arshiaabazari/biphasic-FES-stimulator/Docs/Images/breadboard_prototype.jpg

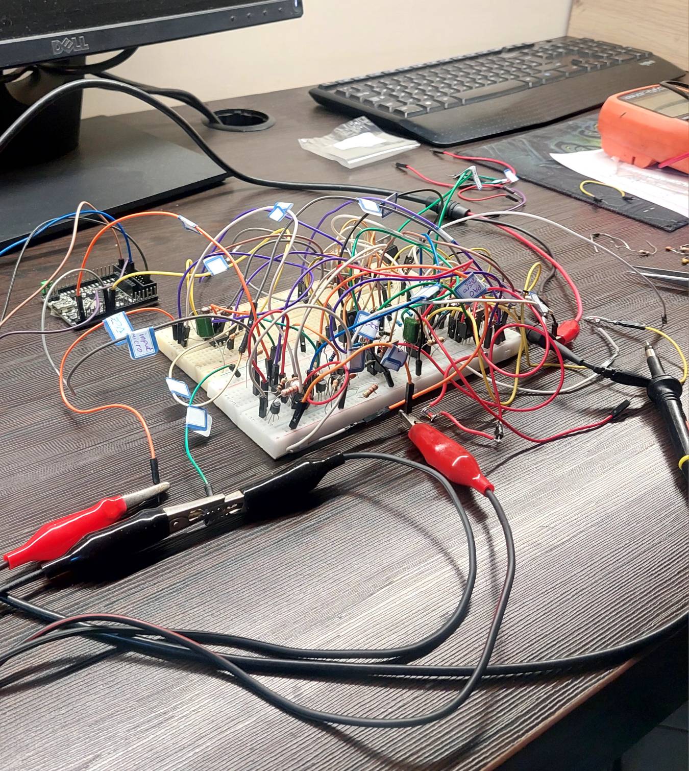
Docs/Images/breadboard_prototype.jpg
