arshiaabazari/biphasic-FES-stimulator/Docs/Images/final-hbridge_schematic-Proteus.png

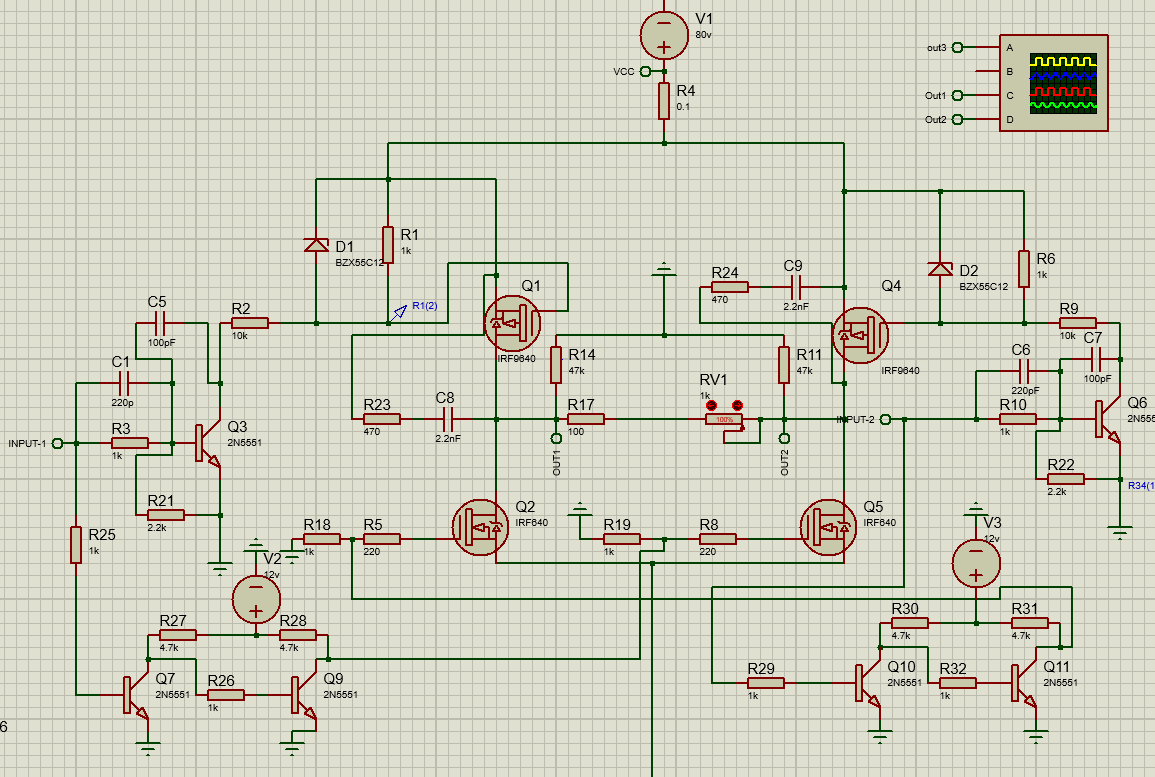
Docs/Images/final-hbridge_schematic-Proteus.png
