arshiaabazari/biphasic-FES-stimulator/Docs/Images/first-hbridge_schematic-Altium.jpg

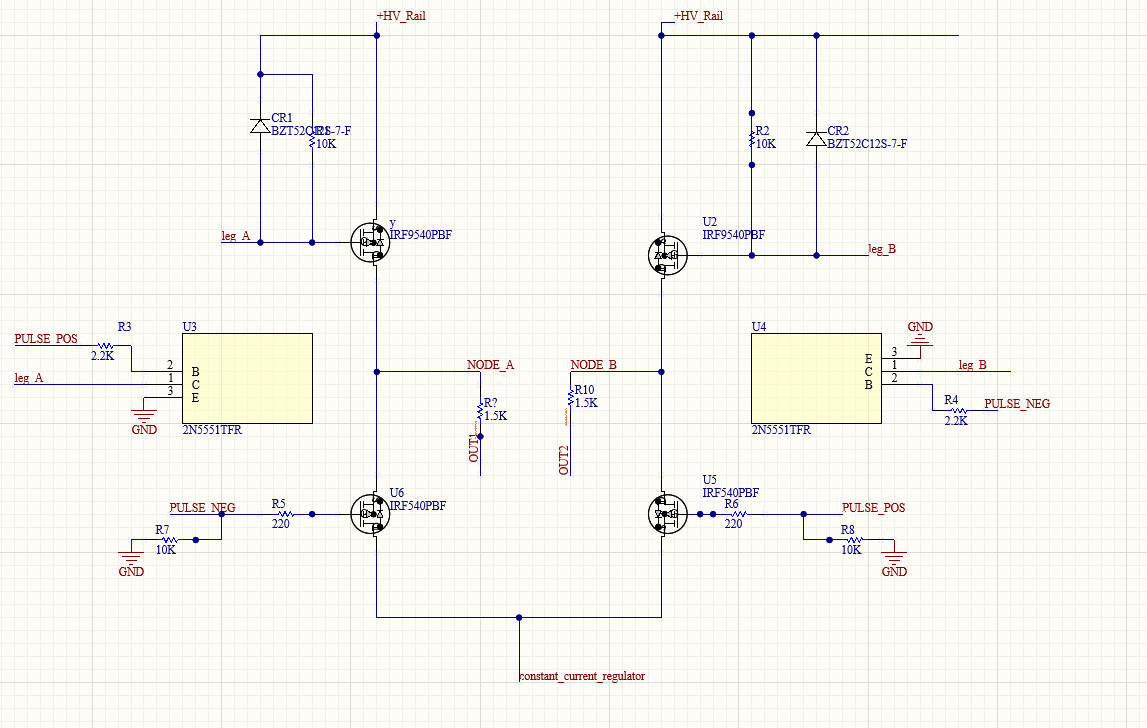
Docs/Images/first-hbridge_schematic-Altium.jpg
