arshiaabazari/biphasic-FES-stimulator/Docs/Images/oscilloscope_waveform-12V.jpg

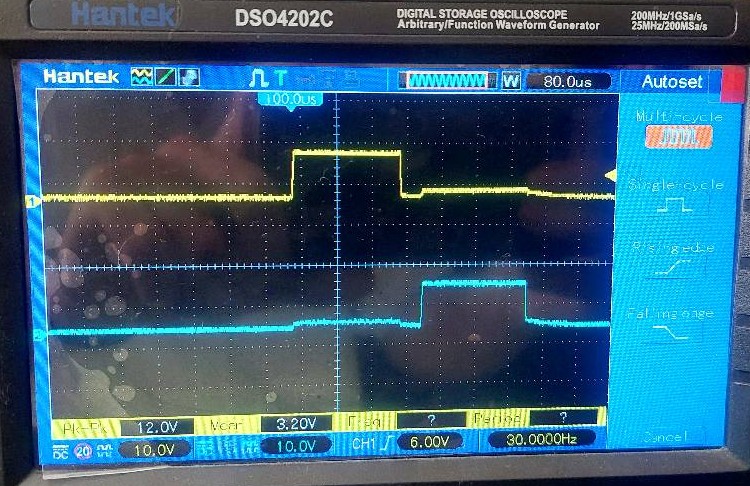
Docs/Images/oscilloscope_waveform-12V.jpg
