arshiaabazari/biphasic-FES-stimulator/Docs/Images/pulse_architecture.jpg

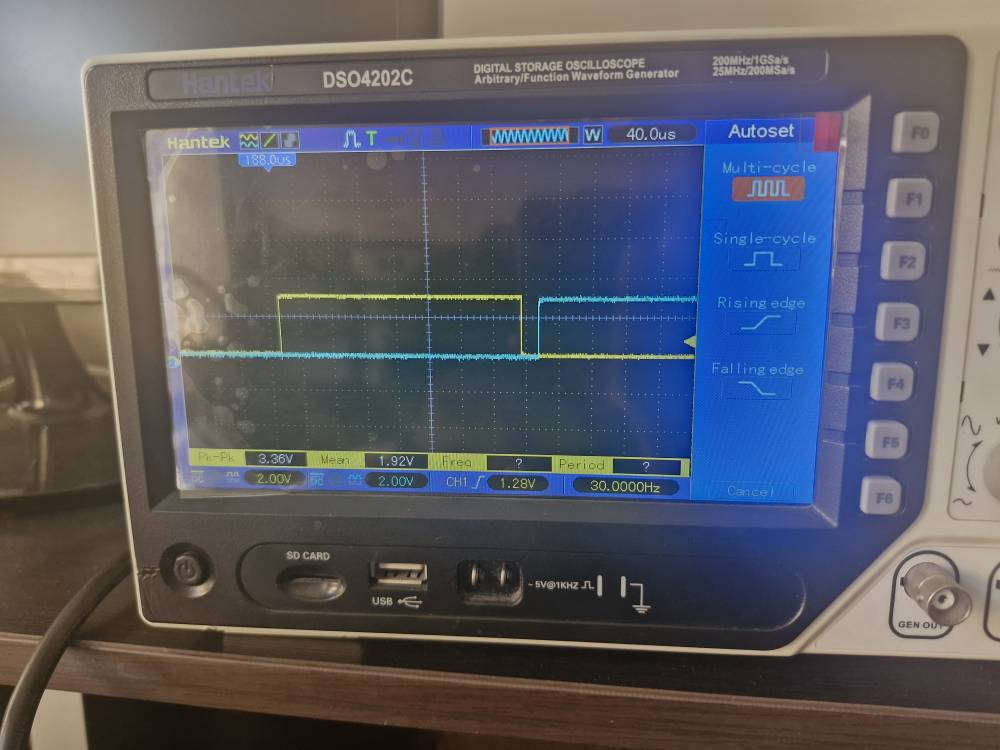
Docs/Images/pulse_architecture.jpg
