arshiaabazari/biphasic-FES-stimulator/Firmware/Core/Src/main.c

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
/* Includes ------------------------------------------------------------------*/
#include "main.h"

TIM_HandleTypeDef htim3;

void SystemClock_Config(void);
static void MX_GPIO_Init(void);
static void MX_TIM3_Init(void);
/* USER CODE BEGIN 0 */
void delay_us(uint16_t us)
{
    __HAL_TIM_SET_COUNTER(&htim3, 0);
    while (__HAL_TIM_GET_COUNTER(&htim3) < us);
}
/* USER CODE END 0 */

/**
  * @brief  The application entry point.
  * @retval int
  */
int main(void)
{

  /* MCU Configuration--------------------------------------------------------*/

  /* Reset of all peripherals, Initializes the Flash interface and the Systick. */
  HAL_Init();

  /* Configure the system clock */
  SystemClock_Config();

  /* Initialize all configured peripherals */
  MX_GPIO_Init();
  MX_TIM3_Init();
  /* USER CODE BEGIN 2 */
  HAL_TIM_Base_Start(&htim3);
  /* USER CODE END 2 */

  /* Infinite loop */
  /* USER CODE BEGIN WHILE */
  while (1)
  {
    /* USER CODE END WHILE */

	  /* USER CODE BEGIN 3 */
	      /* فاز اول: تحریک مثبت به مدت 250 میکروثانیه */
	      HAL_GPIO_WritePin(GPIOA, GPIO_PIN_0, GPIO_PIN_SET);
	      delay_us(250);
	      HAL_GPIO_WritePin(GPIOA, GPIO_PIN_0, GPIO_PIN_RESET);

	      /* زمان مرده برای جلوگیری از شورت در پل H */
	      delay_us(40);

	      /* فاز دوم: تحریک منفی به مدت 250 میکروثانیه */
	      HAL_GPIO_WritePin(GPIOA, GPIO_PIN_1, GPIO_PIN_SET);
	      delay_us(250);
	      HAL_GPIO_WritePin(GPIOA, GPIO_PIN_1, GPIO_PIN_RESET);

	      /* زمان خاموشی تا تکمیل دوره تناوب 40 میلی‌ثانیه‌ای (فرکانس 25 هرتز) */
	      HAL_Delay(32);
	      delay_us(800);
	    }
	    /* USER CODE END 3 */
}

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
