arshiaabazari/biphasic-FES-stimulator/Firmware/STM-SMART.ioc

Mcu.UserName=STM32F030C8Tx
PA0.Signal=GPIO_Output
PA1.Signal=GPIO_Output
PA13.Signal=SYS_SWDIO
PA14.Signal=SYS_SWCLK
PF0-OSC_IN.Signal=RCC_OSC_IN
PF1-OSC_OUT.Signal=RCC_OSC_OUT
