arshiaabazari/biphasic-FES-stimulator/(commit log)

2026-10-17 feat: initial commit of FES firmware, architecture docs, and schematics
2026-11-04 docs: add in-vivo electrode trial captures and 80V pulse-train oscilloscope verification
    - Added in-vivo placement photo targeting common peroneal nerve and tibialis anterior
    - Documented oscilloscope captures with 10x probe attenuation (~80V amplitude)
    - Added continuous 25 Hz pulse train validation
